MicrochipTech/veryVerilog/doc/USB_Bridge.pdf

## USB bridge

Developer’s guide

## Main functions

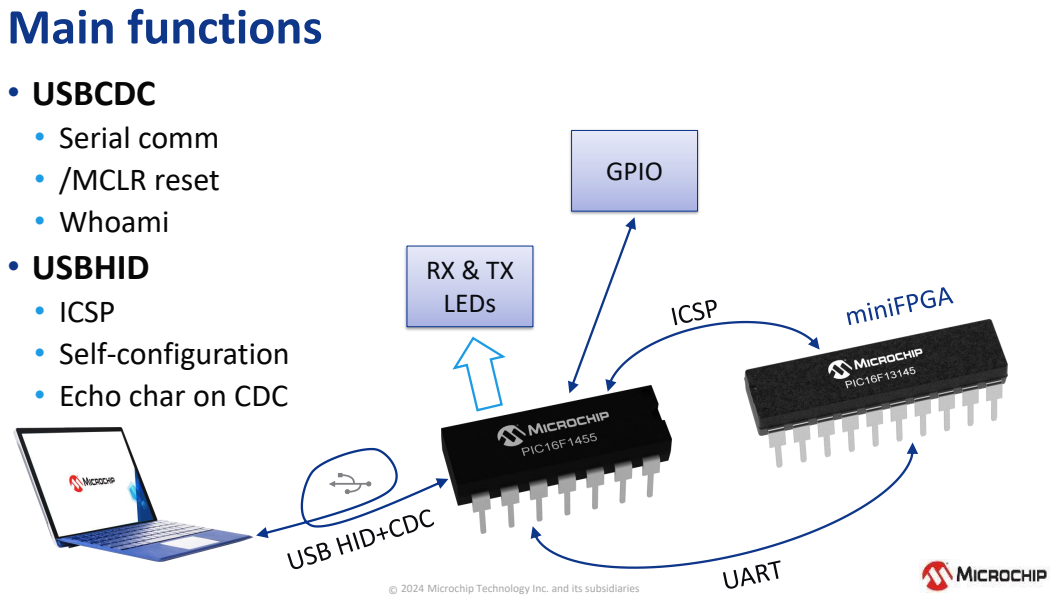
[picture p10: page 2]
17 December 2024 ©; Microchip Technology Inc. and its subsidiaries; RX & TX LEDs; GPIO

• USBCDC
• Serial comm
• /MCLR reset
• Whoami
• USBHID
• ICSP
• Self-configuration
• Echo char on CDC

## Pinout

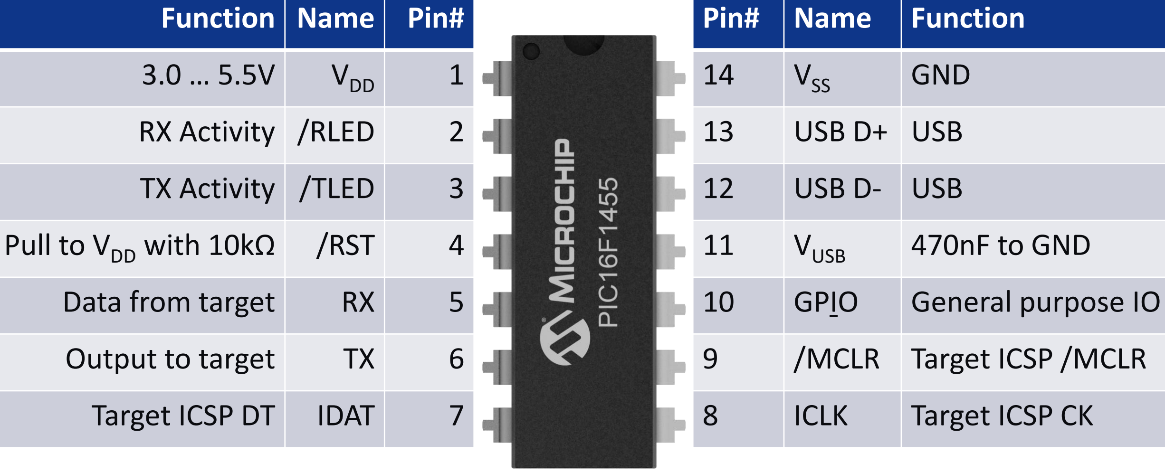
[picture p11: figure]
Pin#; Name; Function; VSS; GND; USB D+; USB; USB D-; VUSB; 470nF to GND; GPIO; General purpose IO; /MCLR; Target ICSP /MCLR; ICLK; Target ICSP CK; VDD; RX Activity; /RLED; TX Activity; /TLED; Pull to VDD with 10kΩ; /RST; Data from target; Output to target; Target ICSP DT; IDAT

## Logical structure

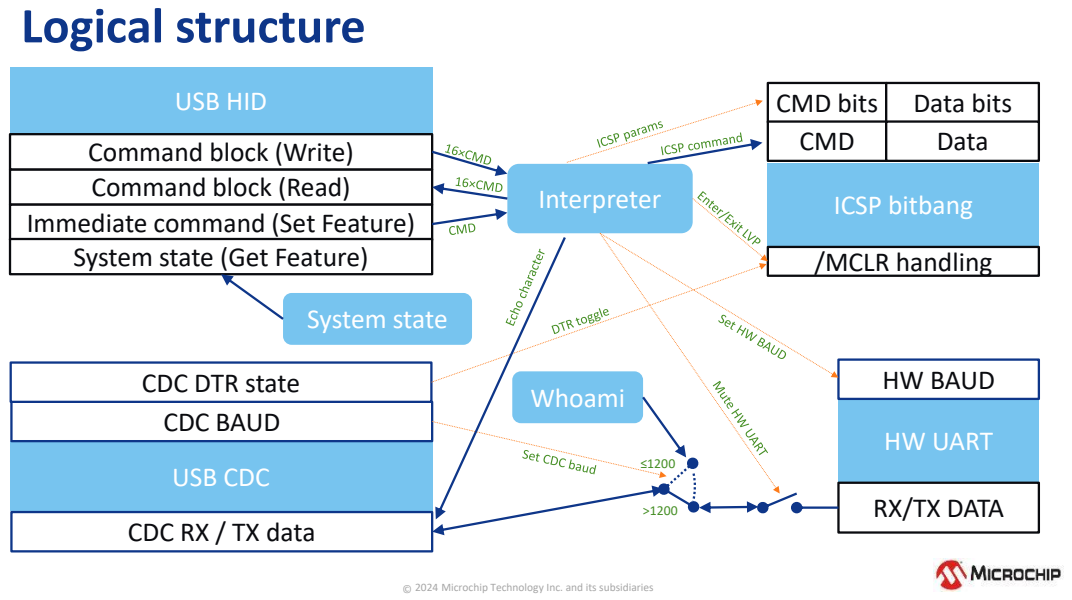
[picture p12: page 4]
HW UART; ICSP bitbang; USB HID; USB CDC; HW BAUD; /MCLR handling; CDC BAUD; CDC DTR state; Whoami; System state

CMD bits | Data bits
CMD | Data

Command block (Write)
Interpreter Command block (Read)
Immediate command (Set Feature)
System state (Get Feature)

RX/TX DATA

CDC RX / TX data

## USB CDC (virtual serial port) interface

- Setting the DTR active will keep target in RESET
- Clearing the DTR will cycle target RESET pin and release RESET
- Setting baud rate ≤1200
- Mutes HW UART
- Sends “Who am I?” JSON string
- Example {"app":"miniFPGA board","USBFW":“0100","meta_cmd":255}
- Setting baud rate >1200
- Connects HW UART to CDC UART
- Unmutes HW UART
- HW baud rate is not affected! (HWBAUD is set by HID commands!)

## USB HID reports

- VID:PID = 0x04D8:0xE594
- Usage page: 0xFF00 (Vendor Page 1)
- Usage: 0x0001 (Vendor Usage 1)
- Report ID 0
- Read data (64bytes)
- Write data (64bytes)
- Get_feature (8bytes)
- Set_feature (8bytes)

## HID get_feature – RPTID0

- Returns 8 bytes with the following structure
Byte0 | Byte1 | Byte2 | Byte3 | Byte4 | Byte5 | Byte6 | Byte7
MCMD_ID | target_state | HWBaud_L | HWBaud_H | HWBaud_U | PORTA | PORTB | PORTC

MCMD_ID → Metacommand value
target_state → 0 – Running (MCLR_HIGH) 1 – Transitioning from STOP to RUN (MCLR_LOW) 2 – Stopped (MCLR_LOW)

HWBaud → HW UART baud rate = (HWBaud_U << 16) + (HWBaud_H << 8) + HWBaud_L PORTA → PORTA value at the moment of executing get_feature
PORTB → PORTB value at the moment of executing get_feature
PORTC → PORTC value at the moment of executing get_feature

## HID set_feature – RPTID0

- Executes a single metacommand
- Not all meta commands are available via set_feature
- 8byte buffer is interpreted as:
- Command (1byte) + no parameters
- Command (1byte) + unsigned byte parameter (1byte)
- Command (1byte) + unsigned word parameter (2bytes)
Byte0 | Byte1 | Byte2 | Byte3 | Byte4 | Byte5 | Byte6 | Byte7
MCMD_ID | × Don’t care | × Don’t care | × Don’t care | × Don’t care | × Don’t care | × Don’t care | × Don’t care
Byte0 | Byte1 | Byte2 | Byte3 | Byte4 | Byte5 | Byte6 | Byte7
MCMD_ID | Parameter8 | × Don’t care | × Don’t care | × Don’t care | × Don’t care | × Don’t care | × Don’t care
Byte0 | Byte1 | Byte2 | Byte3 | Byte4 | Byte5 | Byte6 | Byte7
MCMD_ID | Parameter16 (L:H) | | × Don’t care | × Don’t care | × Don’t care | × Don’t care | × Don’t care

## HID set_feature – RPTID0

ICSP_MCMD_SET_HWUART_BAUD = 1
- Sets the HW UART new Baud rate
- The 100×Word parameter is set as new Baud rate for HW UART
- Word parameter range is 2…1152
- For 9600 baud the Word parameter = 96, for 115200 → 1152
- Example: 57600baud→57600/100→576→0x240→0x40;0x02
Byte0 | Byte1 | Byte2 | Byte3 | Byte4 | Byte5 | Byte6 | Byte7
0x01 | <new Baud rate / 100> | | × Don’t care | × Don’t care | × Don’t care | × Don’t care | × Don’t care
Byte0 | Byte1 | Byte2 | Byte3 | Byte4 | Byte5 | Byte6 | Byte7
0x01 | 0x40 | 0x02 | × Don’t care | × Don’t care | × Don’t care | × Don’t care | × Don’t care

## HID set_feature – RPTID0

ICSP_MCMD_SET_METACMD = 2
- Sets the new metacommand value
- The byte parameter is set as new CMD_ID_MCMD
- Example: Set metacommand CMD_ID to 186 → 0xBA
Byte0 | Byte1 | Byte2 | Byte3 | Byte4 | Byte5 | Byte6 | Byte7
0x02 | <new CMD_ID_MCMD> | × Don’t care | × Don’t care | × Don’t care | × Don’t care | × Don’t care | × Don’t care
Byte0 | Byte1 | Byte2 | Byte3 | Byte4 | Byte5 | Byte6 | Byte7
0x02 | 0xBA | × Don’t care | × Don’t care | × Don’t care | × Don’t care | × Don’t care | × Don’t care

## HID set_feature – RPTID0

ICSP_MCMD_HWUART_ENABLE = 10
- Enables / disables HW UART bridging to USB CDC
- Non-zero byte parameter enables bridging
- Example: Disable HWUART to CDC Bridging: Enable=0 → 0x00
- Example: Enable HWUART to CDC Bridging: Enable=1 → 0x01
Byte0 | Byte1 | Byte2 | Byte3 | Byte4 | Byte5 | Byte6 | Byte7
0x0A | <Enable bridging> | × Don’t care | × Don’t care | × Don’t care | × Don’t care | × Don’t care | × Don’t care
Byte0 | Byte1 | Byte2 | Byte3 | Byte4 | Byte5 | Byte6 | Byte7
0x0A | 0x00 | × Don’t care | × Don’t care | × Don’t care | × Don’t care | × Don’t care | × Don’t care
Byte0 | Byte1 | Byte2 | Byte3 | Byte4 | Byte5 | Byte6 | Byte7
0x0A | 0x01 | × Don’t care | × Don’t care | × Don’t care | × Don’t care | × Don’t care | × Don’t care

## HID set_feature – RPTID0

ICSP_MCMD_USBCDC_SEND = 11
- Send ASCII character to USB CDC. HW UART is not affected
- Byte parameter is the ASCII value to send to CDC UART
- Used to check if serial port open is connected to this HID device
- Example: Send ‘U’ to USBCDC ‘U’→0x55
Byte0 | Byte1 | Byte2 | Byte3 | Byte4 | Byte5 | Byte6 | Byte7
0x0B | <ASCII Character> | × Don’t care | × Don’t care | × Don’t care | × Don’t care | × Don’t care | × Don’t care
Byte0 | Byte1 | Byte2 | Byte3 | Byte4 | Byte5 | Byte6 | Byte7
0x0B | 0x55 | × Don’t care | × Don’t care | × Don’t care | × Don’t care | × Don’t care | × Don’t care

## HID OUT (write) commands

- USB HID interface is used to send ICSP commands to target
- All commands are 4 bytes in length
- Each command is passed through an internal interpreter
- HID Write always sends 16 commands, 4bytes each
- If less than 16 commands are used, fill rest with “MCMD_NOP”

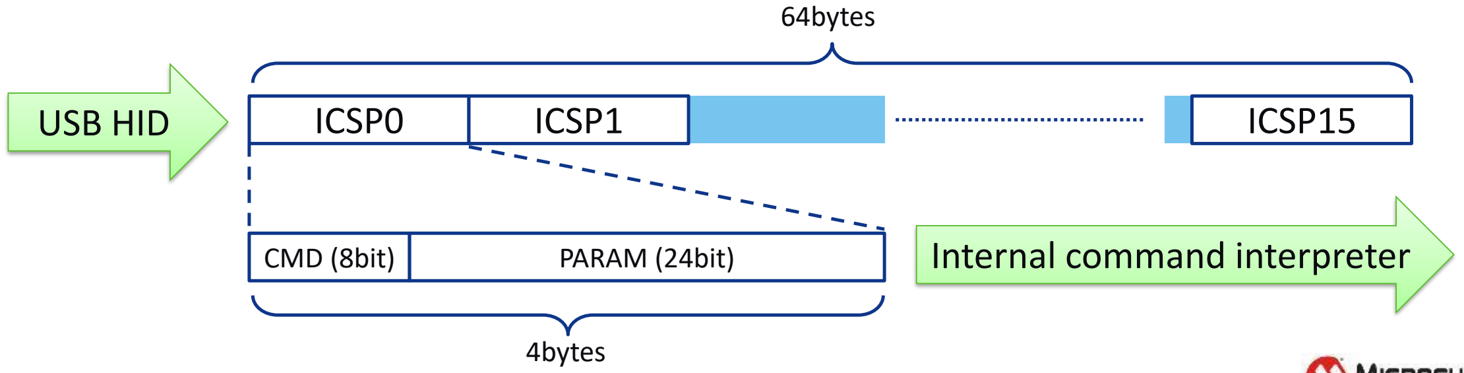
[picture p13: figure]
ICSP0; ICSP1; ICSP15; CMD (8bit); PARAM (24bit); 64bytes; 4bytes; USB HID; Internal command interpreter

## HID OUT (write) ICSP commands

- An ICSP command consist of a CMD and optionally a Payload
- The CMD & Payload values are in the PIC Programming Specs DS
- {#CMD bits} and {#Data bits} are adjustable (described later)
- The USB bridge will shift out total {#CMD bits} + {#Data bits} bits
- No Payload expected? Set {#Data bits} to 0!

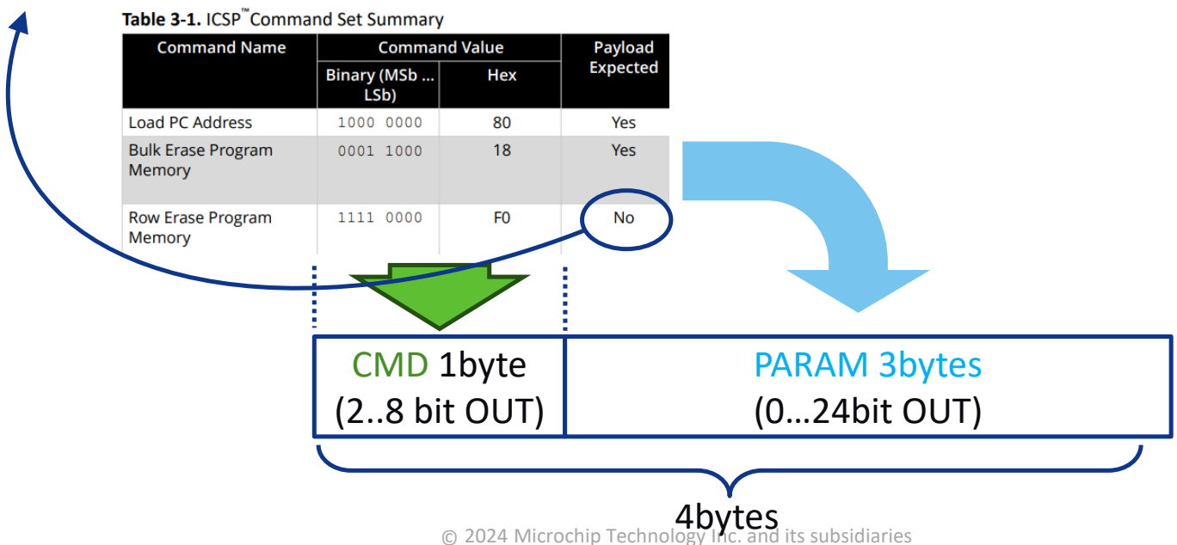
[picture p14: figure]
CMD 1byte (2..8 bit OUT); PARAM 3bytes (0…24bit OUT); 4bytes

## HID ICSP metacommands

- Metacommands not part of the ICSP protocol
- Metacommand if CMD_ID == CMD_ID_MCMD (default 0xFF)
- Usually for setting parameters and control the interpreter
- Example metacommands:
- Enter / exit LVP mode / reset target
- Change HW baud
- Delay X microsec
- Read data
- Echo char from HID to CDC
- Read data from target
- etc.
- Only transmitting data to the target if specifically noted in doc.

## HID ICSP metacommand format

- Only Interpreter decides if command is transmitted over ICSP or treated as metacommand
- All commands where CMD_ID ≠ CMD_ID_MCMD are transmitted to ICLK/IDAT pins
- Metacommand has 0 or 1 parameter (8/16bit)
Byte0 | Byte1 | Byte2 | Byte3
CMD_ID (8bit) | PARAM (24bit)
CMD_ID_MCMD | MCMD_ID | × Don’t care
CMD_ID_MCMD | MCMD_ID | Parameter8 | × Don’t care
CMD_ID_MCMD | MCMD_ID | Parameter16 (L:H)

ICSP CMD
Metacmd
Metacmd
Metacmd

## HID IN (read) commands

- After execution of a command block, a HID response is sent
- All command responses are 4 bytes in length
- HID Reply always sends 16 responses, 4bytes each
- Most of the responses are equal to the command byte sequence

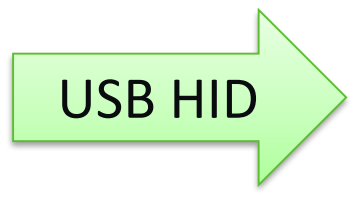
[picture p15: figure]
USB HID

RESP0 | RESP1 | RESP15

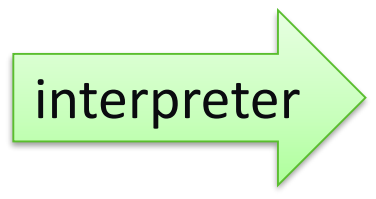
[picture p16: figure]
interpreter

Interpreter response (32bit)

64bytes

4bytes

## HID metacommand

ICSP_MCMD_NOP = 0
- No operation. Used for filling the HID buffer
- Example: No operation (CMD_ID_MCMD = 0xFF)
Byte0 | Byte1 | Byte2 | Byte3
CMD_ID_MCMD | 0x00 | × Don’t care
Reply → | CMD_ID_MCMD | 0x00 | × Don’t care < same as CMD Byte2 and Byte3 >
Byte0 | Byte1 | Byte2 | Byte3
0xFF | 0x00 | 0x00 | 0x00
Reply → | 0xFF | 0x00 | 0x00 | 0x00

CMD →

CMD →

## HID metacommand

ICSP_MCMD_SET_HWUART_BAUD = 1
- Sets the HW UART new Baud rate
- The 100×Word parameter is set as new Baud rate for HW UART
- Word parameter range is 2…1152
- For 9600 baud the Word parameter = 96, for 115200 → 1152
- Exact baud baud rate set can be read with HID get_feature
- Example: 57600baud→57600/100→576→0x240→0x40;0x02
Byte0 | Byte1 | Byte2 | Byte3
CMD_ID_MCMD | 0x01 | <new Baud rate / 100>
Reply → | CMD_ID_MCMD | 0x01 | <Requested Baud rate / 100 >
Byte0 | Byte1 | Byte2 | Byte3
0xFF | 0x01 | 0x40 | 0x02
Reply → | 0xFF | 0x01 | 0x40 | 0x02

CMD →

CMD →

## HID metacommand

ICSP_MCMD_SET_METACMD = 2
- Sets the new CMD_ID_MCMD
- CMD_ID_MCMD changes only if new CMD_ID_MCMD ≤255
- Example: Set new CMD_ID_MCMD to 100→0x0064→0x64;0x00
- Example: Set new CMD_ID_MCMD to 999→0x03E7→0xE7;0x03
Byte0 | Byte1 | Byte2 | Byte3
CMD_ID_MCMD | 0x02 | <new CMD_ID_MCMD>
Reply → | Previous CMD_ID_MCMD | 0x02 | <CMD_ID_MCMD in effect after this command completed>
Byte0 | Byte1 | Byte2 | Byte3
0xFF | 0x02 | 0x64 | 0x00
Reply → | 0xFF | 0x02 | 0x64 | 0x00

CMD →

CMD →

Byte0 | Byte1 | Byte2 | Byte3
0x64 | 0x02 | 0xE7 | 0x03
Reply → | 0x64 | 0x02 | 0x64 | 0x00

CMD →

## HID metacommand

ICSP_MCMD_SET_CMD_BITS = 3
- Sets # of bits transmitted to target from the ICSP 8bit CMD_ID
- 1 < {#CMD bits} ≤ 8 (Default: =8)
- Example: Set new {#CMD bits} to 6→0x0006→0x06;0x00
- Example: Set new {#CMD bits} to 9999→0x270F→0x0F;0x27
Byte0 | Byte1 | Byte2 | Byte3
CMD_ID_MCMD | 0x03 | <new {#CMD bits} >
Reply → | CMD_ID_MCMD | 0x03 | <{#CMD bits} in effect after this command completed>
Byte0 | Byte1 | Byte2 | Byte3
0xFF | 0x03 | 0x06 | 0x00
Reply → | 0xFF | 0x03 | 0x06 | 0x00

CMD →

CMD →

Byte0 | Byte1 | Byte2 | Byte3
0xFF | 0x03 | 0x0F | 0x27
Reply → | 0xFF | 0x03 | 0x06 | 0x00

CMD →

## HID metacommand

ICSP_MCMD_SET_DATA_BITS = 4
- Sets # of bits transmitted to target from the ICSP 24bit PARAM
- 0 ≤ {#Data bits} ≤ 24 (Default: =24)
- Example: Set new {#Data bits} to 16→0x0010→0x10;0x00
- Example: Set new {#Data bits} to 55→0x0037→0x37;0x00
Byte0 | Byte1 | Byte2 | Byte3
CMD_ID_MCMD | 0x04 | <new {#Data bits} >
Reply → | CMD_ID_MCMD | 0x04 | <{#Data bits} in effect after this command completed>
Byte0 | Byte1 | Byte2 | Byte3
0xFF | 0x04 | 0x10 | 0x00
Reply → | 0xFF | 0x04 | 0x10 | 0x00

CMD →

CMD →

Byte0 | Byte1 | Byte2 | Byte3
0xFF | 0x04 | 0x37 | 0x00
Reply → | 0xFF | 0x04 | 0x10 | 0x00

CMD →

## HID metacommand with pin state changes

ICSP_MCMD_LVP_ENTER = 5
- Enter low voltage programming mode if possible (takes ≈25ms)
- LVP can be disabled in CONFIG bits ( )
- Factory shipped (blank) devices has LVP enabled
- It is not verified if the target is successfully in LVP
- The command will keep target MCLR pin low, ICLK→OutputL ( )
- Example: Enter LVP with default (MSB first) method
Byte0 | Byte1 | Byte2 | Byte3
CMD_ID_MCMD | 0x05 | × Don’t care
Reply → | CMD_ID_MCMD | 0x05 | × Don’t care < same as CMD Byte2 and Byte3 >
Byte0 | Byte1 | Byte2 | Byte3
0xFF | 0x05 | 0x00 | 0x00
Reply → | 0xFF | 0x05 | 0x00 | 0x00

CMD →

CMD →

## HID metacommand with pin state changes

ICSP_MCMD_LVP_ENTER = 5
- In FW v1.2 alternative method for enter LVP is defined
- Method 1 = 0xFE01
- Valid for devices where LSb must be shifted in first to enter LVP
- Shift direction change affects only the enter LVP key sequence
- Example: Enter LVP with LSB first method→0xFE01→0x01;0xFE
Byte0 | Byte1 | Byte2 | Byte3
CMD_ID_MCMD | 0x05 | Method ID
Reply → | CMD_ID_MCMD | 0x05 | Method ID
Byte0 | Byte1 | Byte2 | Byte3
0xFF | 0x05 | 0x01 | 0xFE
Reply → | 0xFF | 0x05 | 0x01 | 0xFE

CMD →

CMD →

V1.2

## HID metacommand with pin state changes

ICSP_MCMD_LVP_EXIT = 6
- Set ICLK→Input, IDAT→INPUT, release target MCLR
- Example: Release target MCLR → run the code
Byte0 | Byte1 | Byte2 | Byte3
CMD_ID_MCMD | 0x06 | × Don’t care
Reply → | CMD_ID_MCMD | 0x06 | × Don’t care < same as CMD Byte2 and Byte3 >
Byte0 | Byte1 | Byte2 | Byte3
0xFF | 0x06 | 0x00 | 0x00
Reply → | 0xFF | 0x06 | 0x00 | 0x00

CMD →

CMD →

## HID metacommand

ICSP_MCMD_DELAY_us = 7
- Immediate delay for <parameter16> µsec
- Delays in a loop⇒<parameter16>×(1µsec + loop instruction exec)
- Maximum delay ≈65.5msec
- Example: Delay ≈1ms→1000→0x03E8→0xE8;0x03
Byte0 | Byte1 | Byte2 | Byte3
CMD_ID_MCMD | 0x07 | Delay length in µsec
Reply → | CMD_ID_MCMD | 0x07 | Delay length in µsec
Byte0 | Byte1 | Byte2 | Byte3
0xFF | 0x07 | 0xE8 | 0x03
Reply → | 0xFF | 0x07 | 0xE8 | 0x03

CMD →

CMD →

## HID metacommand with pin state changes

ICSP_MCMD_READ_CMD = 8
- Sends RD_CMD_ID ICSP command and reads data response
- Parameter RD_CMD_ID sent according to {#CMD bits}
- Replies zero padded {#Data bits} from device
- Example: Read empty FLASH word from PIC16F13145
Read Data from NVM→ RD_CMD_ID=0xFC Empty FLASH=0x003FFF
Byte0 | Byte1 | Byte2 | Byte3
CMD_ID_MCMD | 0x08 | ICSP Read RD_CMD_ID | × Don’t care
Reply → | RD_CMD_ID | DATA_L | DATA_H | DATA_U
Byte0 | Byte1 | Byte2 | Byte3
0xFF | 0x08 | 0xFC | 0x00
Reply → | 0xFC | 0xFF | 0x3F | 0x00

CMD →

CMD →

0x003FFF

## HID metacommand

ICSP_MCMD_GET_HWUART_BAUD = 9
- Get exact HW UART baud rate
- Example: HW UART baud?→Exact baud=115213→0x01C20D
Byte0 | Byte1 | Byte2 | Byte3
CMD_ID_MCMD | 0x00 | × Don’t care
Reply → | CMD_ID_MCMD | Exact baud rate <24bits>
Byte0 | Byte1 | Byte2 | Byte3
0xFF | 0x09 | 0x00 | 0x00
Reply → | 0xFF | 0x0D | 0xC2 | 0x01

CMD →

CMD →

## HID metacommand

ICSP_MCMD_HWUART_ENABLE = 10
- Enables or disables HWUART CDC bridging
- Useful for avoiding random characters during programming
- Example: Enable HWUART CDC bridging →0x0001→0x01;0x00
- Example: Disable HWUART CDC bridging →0x0000→0x00;0x00
Byte0 | Byte1 | Byte2 | Byte3
CMD_ID_MCMD | 0x0A | <Non-zero to enable HWUART to CDC bridging>
Reply → | CMD_ID_MCMD | 0x0A | 0x0000→Bridging disabled 0x0001→Bridging enabled
Byte0 | Byte1 | Byte2 | Byte3
0xFF | 0x0A | 0x01 | 0x00
Reply → | 0xFF | 0x0A | 0x01 | 0x00

CMD →

CMD →

Byte0 | Byte1 | Byte2 | Byte3
0xFF | 0x0A | 0x00 | 0x00
Reply → | 0xFF | 0x0A | 0x00 | 0x00

CMD →

## HID metacommand

ICSP_MCMD_USBCDC_SEND = 11
- Sends ASCII character to USB UART (USBCDC)
- HWUART not affected!
- Reply contains Success/Fail indication
- Used to match HID to USBCDC
- Example: Send ‘U’ to USBCDC → 0x55 → 0x0055 → 0x55;0x00
Byte0 | Byte1 | Byte2 | Byte3
CMD_ID_MCMD | 0x0B | ASCII character value to send via USBCDC | × Don’t care
Reply → | CMD_ID_MCMD | 0x0B | ASCII character value | 0x00→queue full 0x01→ASCII char queued
Byte0 | Byte1 | Byte2 | Byte3
0xFF | 0x0B | 0x55 | 0x00
Reply → | 0xFF | 0x0B | 0x55 | 0x01

CMD →

CMD →

## HID metacommand with pin state changes

ICSP_MCMD_GPIO = 12
- Controls IO pins (0=Out, 1=Input, 0=Low, 1=High)
- 1

st set direction, 2nd write outputs, 3rd read inputs
- Reply contains digital value on the PIN (0=Low, 1=High)
- Used to blink RX/TX LEDs, add virtual buttons & LEDs
- Setting Pin5 or Pin6 to output, disables HW UART!
- Example: TXLED=off, RXLED=on, other pins=input → 0xFC;0x02
Byte0 | Byte1 | Byte2 | Byte3
CMD_ID_MCMD | 0x0B | Pin I/O Direction values | Set OUTPUT pins H/L values
Reply → | CMD_ID_MCMD | 0x0B | Pin logic levels bit values | OUTPUT pin bit values, × for input bits
Byte0 | Byte1 | Byte2 | Byte3
0xFF | 0x0B | 0xFC | 0x02
Reply → | 0xFF | 0x0B | 0xFE | 0x02

CMD →

CMD →

IC Pin # | Bit
2-/RLED | 0 (IO)
3-/TLED | 1 (IO)
5-RX | 2 (IO )
6-TX | 3 (IO )
7-IDAT | 4 (IO)
8-ICLK | 5 (IO)
9-/MCLR | 6 (IO)
10-GPIO | 7 (IO)

V1.2

## HID metacommand

ICSP_MCMD_DELAY_ms = 13
- Immediate delay for <parameter16> msec
- Maximum delay ≈1h5min
- Delay will be interrupted on reception of new HID Write packet
- On interrupt ,no reply, new packet will be processed from ICSP0
- Example: Delay ≈100ms→100→0x0064→0x64;0x00
Byte0 | Byte1 | Byte2 | Byte3
CMD_ID_MCMD | 0x0D | Delay length in msec
Reply → | CMD_ID_MCMD | 0x0D | Delay length in msec
Byte0 | Byte1 | Byte2 | Byte3
0xFF | 0x0D | 0x64 | 0x03
Reply → | 0xFF | 0x0D | 0x64 | 0x03

CMD →

CMD →

V1.2

## ICSP REVID&DEVID read sequence example

PIC16F13145

byte0 | byte1 | byte2 | byte3 | Comment
0xFF | 0x06 | 0x00 | 0x00 | ICSP_MCMD_LVP_EXIT = 6 → LVP Exit (Make sure, chip is able to go in LVP)
0xFF | 0x03 | 0x08 | 0x00 | ICSP_MCMD_SET_CMD_BITS = 3 → Set ICSP {#CMD bits} to 8 (Pgspec P12 - 3.2 Program/Verify Commands)
0xFF | 0x04 | 0x18 | 0x00 | ICSP_MCMD_SET_DATA_BITS = 4 → Set ICSP {#Data bits} to 24 (Pgspec P12 - 3.2 Program/Verify Commands)
0xFF | 0x05 | 0x00 | 0x00 | ICSP_MCMD_LVP_ENTER = 5 → LVP Enter with MSB first method (Pgspec P11 – 3.1.2 Low-Voltage Programming (LVP) Mode)
0x80 | 0x0A | 0x00 | 0x01 | HID OUT (write) ICSP commands → Set program counter to REVID location(0x8005<<1) (Pgspec P14 - 3.2.1 Load PC Address)
0xFF | 0x08 | 0xFE | 0x00 | ICSP_MCMD_READ_CMD = 8 → Read location at PC with PC increment → REVID (Pgspec P16 - 3.2.5 Read Data from NVM )
0xFF | 0x08 | 0xFC | 0x00 | ICSP_MCMD_READ_CMD = 8 → Read location at PC → DEVID (Pgspec P16 - 3.2.5 Read Data from NVM )
0xFF | 0x06 | 0x00 | 0x00 | ICSP_MCMD_LVP_EXIT = 6 → LVP Exit
0xFF | 0x00 | 0x00 | 0x00 | ICSP_MCMD_NOP = 0 → NOP
0xFF | 0x00 | 0x00 | 0x00 | ICSP_MCMD_NOP = 0 → NOP |
︙ | ︙ | ︙ | ︙ | ︙
︙ | ︙ | ︙ | ︙ | ︙
0xFF | 0x00 | 0x00 | 0x00 | Sixteenth instruction : ICSP_MCMD_NOP = 0 → NOP
byte0 | byte1 | Comment
0x02 | 0xFF | HID set_feature – RPTID0: ICSP_MCMD_SET_METACMD = 2 → No 0xFF ICSP cmd, set CMD_ID_MCMD to 0xFF (Pgspec P13, Table 3-1 . ICSP Command Set)

Programming Specs: DS40002500B (https://ww1.microchip.com/downloads/aemDocuments/documents/MCU08/ProductDocuments/ProgrammingSpecifications/PIC16F13145-Family-Programming-Specification-DS400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)

JS: sendFeatureReport() Win: HidD_SetFeature() PY hidapi: send_feature_report()

JS: write() Win: write() PY hidapi: write()

## ICSP REVID&DEVID read sequence example

PIC16F1455

byte0 | byte1 | byte2 | byte3 | Comment
0xFF | 0x06 | 0x00 | 0x00 | ICSP_MCMD_LVP_EXIT = 6 → LVP Exit (Make sure, chip is able to go in LVP)
0xFF | 0x03 | 0x06 | 0x00 | ICSP_MCMD_SET_CMD_BITS = 3 → Set ICSP {#CMD bits} to 6 (Pgspec P14 - 4.3 Program/Verify Commands)
0xFF | 0x04 | 0x10 | 0x00 | ICSP_MCMD_SET_DATA_BITS = 4 → Set ICSP {#Data bits} to 16 (Pgspec P14 – 4.3 Program/Verify Commands)
0xFF | 0x05 | 0x01 | 0xFE | ICSP_MCMD_LVP_ENTER = 5 → LVP Enter with LSB first method (Pgspec: P13 – 4.2 Low-Voltage Programming (LVP) Mode)
0x00 | 0x00 | 0x00 | 0x00 | HID OUT (write) ICSP commands → Set program counter to CONFIG location (0x8000) (Pgspec P14 - 4.3.1 Load Configuration)
0xFF | 0x04 | 0x18 | 0x00 | ICSP_MCMD_SET_DATA_BITS = 4 → Set ICSP {#Data bits} to 24 → CMD6+4*CMD6bit as parameter = 5×CMD6
0x06 | 0x18 | 0x86 | 0x61 | HID OUT (write) ICSP commands → send 5×{6bit command} 0x06 → 5× Increment pointer → PC=0x8005
0xFF | 0x04 | 0x10 | 0x00 | ICSP_MCMD_SET_DATA_BITS = 4 → Set ICSP {#Data bits} to 16 (Pgspec P14 – 4.3 Program/Verify Commands)
0xFF | 0x08 | 0x04 | 0x00 | ICSP_MCMD_READ_CMD = 8 → Read location at PC → REVID (Pgspec P15 - 3.2.5 Read Data from NVM )
0xFF | 0x04 | 0x00 | 0x00 | ICSP_MCMD_SET_DATA_BITS = 4 → Set ICSP {#Data bits} to 0, Increment address command has no data (Pgspec P14 – 4.3 Program/Verify Commands)
0x06 | 0x00 | 0x00 | 0x00 | HID OUT (write) ICSP commands → Increment PC Address → PC=0x8006 (Pgspec P15 – 4.3.4 Increment Address)
0xFF | 0x04 | 0x10 | 0x00 | ICSP_MCMD_SET_DATA_BITS = 4 → Set ICSP {#Data bits} to 16 (Pgspec P14 – 4.3 Program/Verify Commands)
0xFF | 0x08 | 0x04 | 0x00 | ICSP_MCMD_READ_CMD = 8 → Read location at PC → DEVID (Pgspec P15 - 3.2.5 Read Data from NVM )
0xFF | 0x06 | 0x00 | 0x00 | ICSP_MCMD_LVP_EXIT = 6 → LVP Exit (Make sure, chip is able to go in LVP)
0xFF | 0x00 | 0x00 | 0x00 | ICSP_MCMD_NOP = 0 → NOP
0xFF | 0x00 | 0x00 | 0x00 | ICSP_MCMD_NOP = 0 → NOP
byte0 | byte1 | Comment
0x02 | 0xFF | HID set_feature – RPTID0: ICSP_MCMD_SET_METACMD = 2 → No 0xFF ICSP cmd, set CMD_ID_MCMD to 0xFF (Pgspec P13, Table 4-1 . Command Mapping)

Programming Specs: DS41620C (https://ww1.microchip.com/downloads/en/DeviceDoc/41620C.pdf)

JS: sendFeatureReport() Win: HidD_SetFeature() PY hidapi: send_feature_report()

JS: write() Win: write() PY hidapi: write()

V1.2
