MicrochipTech/veryVerilog/image.png

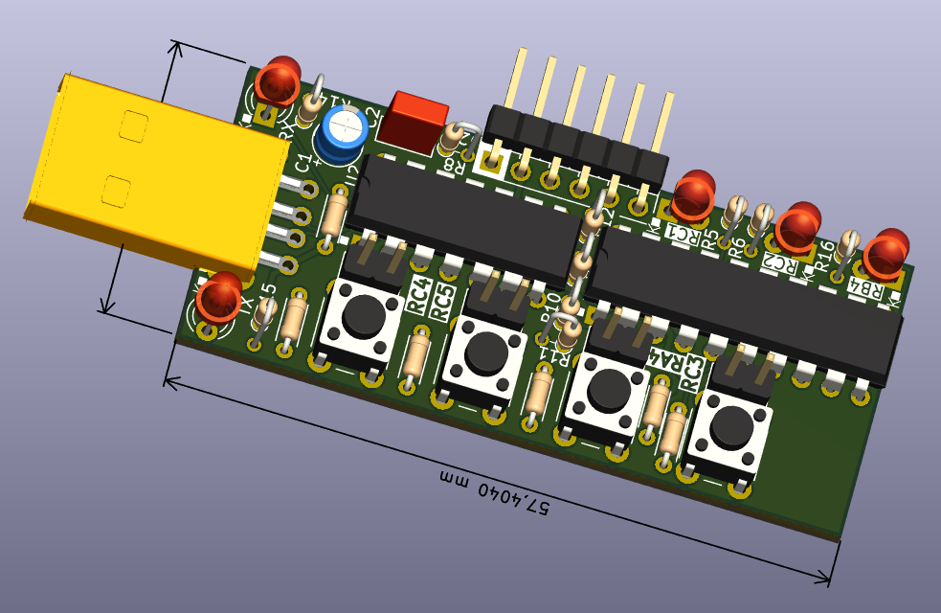
image.png
