MicrochipTech/veryVerilog/PCB/miniFPGA/assembly_steps.xlsx

'Reference' | 'Value' | 'Footprint' | 'Qty' | 'DNP'
'C1' | '4µ7F' | 'Capacitor_THT:CP_Radial_D4.0mm_P2.00mm' | '1' | ''
'C2' | '470nF' | 'Capacitor_THT:C_Rect_L4.6mm_W2.0mm_P2.50mm_MKS02_FKP02' | '1' | ''
'J1' | 'USB_B' | 'Connector_USB:USB_A_CNCTech_1001-011-01101_Horizontal' | '1' | ''
'J2' | 'ICSP_FPGA' | 'Connector_PinHeader_2.54mm:PinHeader_1x06_P2.54mm_Horizontal' | '1' | ''
'JP1,PB1' | 'RC4' | '-- mixed values --' | '2' | ''
'JP2,PB2' | 'RC5' | '-- mixed values --' | '2' | ''
'JP3,PB3' | 'RA4' | '-- mixed values --' | '2' | ''
'JP4,PB4' | 'RC3' | '-- mixed values --' | '2' | ''
'LED1' | 'RX' | 'LED_THT:LED_D3.0mm' | '1' | ''
'LED2' | 'TX' | 'LED_THT:LED_D3.0mm' | '1' | ''
'LED3' | 'RC1' | 'LED_THT:LED_D3.0mm' | '1' | ''
'LED4' | 'RC2' | 'LED_THT:LED_D3.0mm' | '1' | ''
'R1,R2,R3,R4,R7,R13' | '10kΩ' | 'Resistor_THT:R_Axial_DIN0204_L3.6mm_D1.6mm_P5.08mm_Horizontal' | '6' | ''
'R5,R6,R8,R9,R10,R11,R12,R14,R15' | '680Ω' | 'Attila:R_Axial_L3.6mm_D1.6mm_P1.90mm_Vertical' | '9' | ''
'U1' | 'PIC16F13125-IP' | 'Package_DIP:DIP-14_W7.62mm' | '1' | ''
'U2' | 'MCP2221A-IP' | 'Package_DIP:DIP-14_W7.62mm' | '1' | ''
