MicrochipTech/veryVerilog/PCB/miniFPGA/pcb_assembly.txt

J1			
R5,R11,R18
C2
LED1,LED2,LED3,LED4
R1,R2,R3,R4,R6,R7,R8,R9,R10,R12,R13,R14,R15,R16,R17,R19,R20,R21
JP1,JP2,JP3,JP4
PB1,PB2,PB3,PB4
C1			
U1,U2
