MicrochipTech/veryVerilog/(threads)

Thread 4 (2024-12-18):

PCB image shows v2 PCB

apshu, 2024-12-18:
PCB v3 must be rendered and replace /doc/images/pcb.png

Closed 2024-12-19.

Thread 16 (2024-12-19):

Read board analog values

apshu, 2024-12-19:
Metacommand to read analog values from the board (MC team request)

apshu, 2024-12-19:
Reply should have VREF value measured against VDD to calculate more precisely the measured voltage

Thread 27 (2025-03-29):

Add readme to PCB

apshu, 2025-03-29:
Short description about the PCB in the PCB folder

Closed 2025-04-05.

Thread 37 (2025-07-02):

3D rendering in DOCS

apshu, 2025-07-02:
In the “Clean, rinse and dry” section of the manual, there are two 3D renders on how the board should look like when it’s finished. LED5 is missing on both renders.

Thread 41 (2025-07-03):

DCE / DTE clarification on RX/TX

apshu, 2025-07-03:
Add arrow indication to the schematic to represent the flow of UART information . (RX / TX)
