MicrochipTech/veryVerilog/PCB/miniFPGA/miniFPGA_schematics.pdf

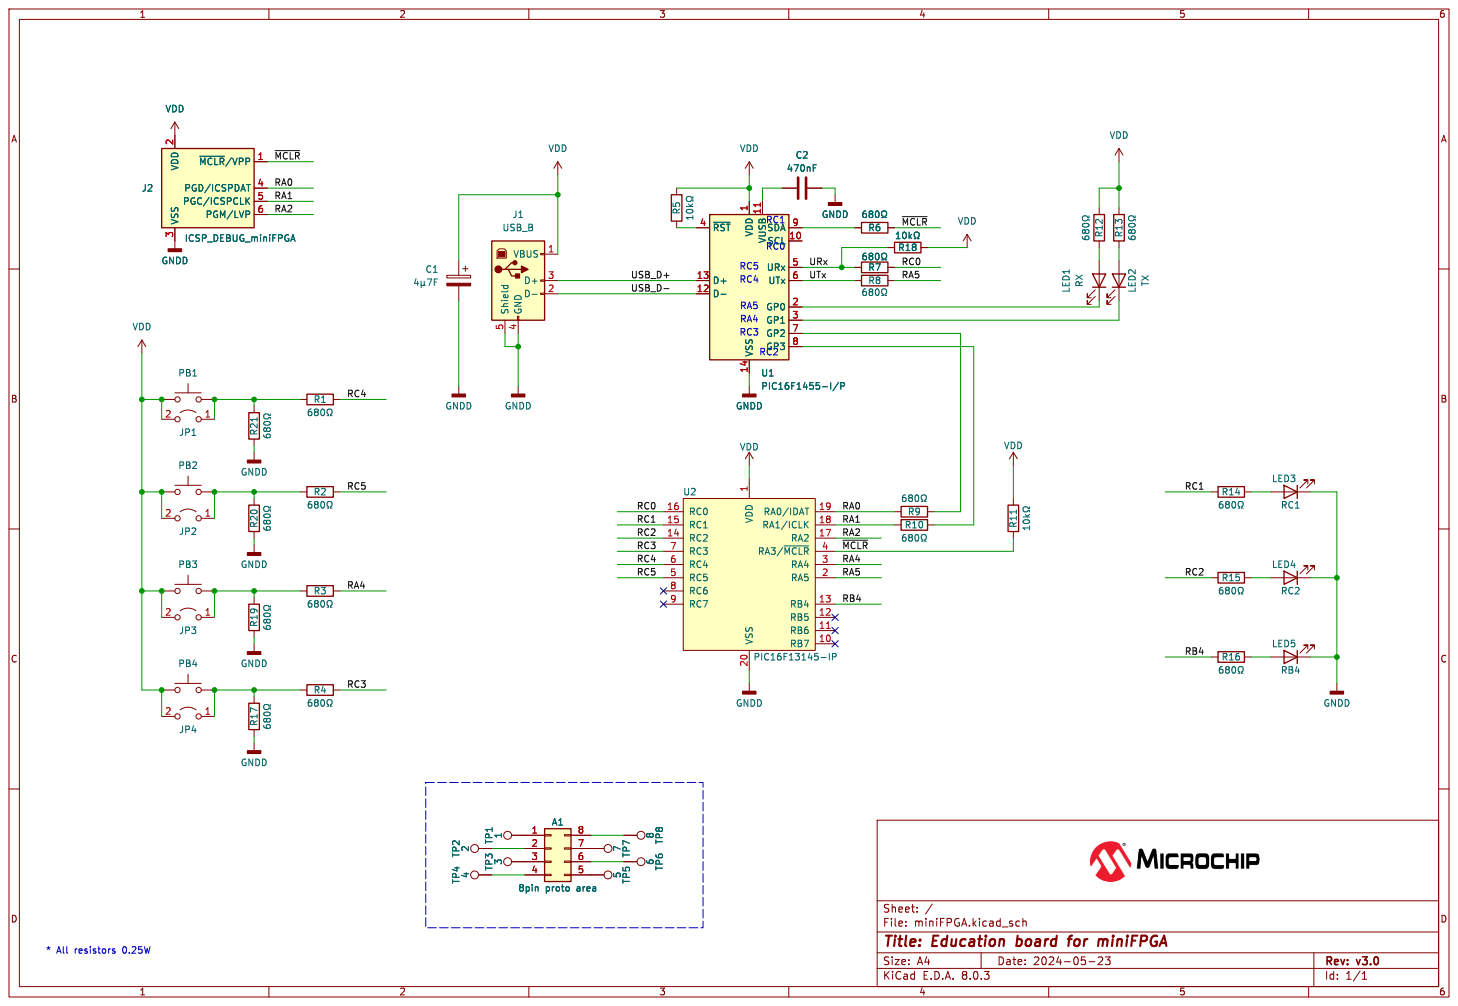
[picture p59: page 1]

3 PGD/ICSPDAT 4 PGC/ICSPCLK 5 PGM/LVP 6 VDD GNDD

VDD LED2 TX R13 þÿ680!& VDD GNDD

3 PGD/ICSPDAT 4 PGC/ICSPCLK 5 PGM/LVP 6

1 SCL 10 VUSB 11 D- 12 D+ 13 VSS 14 GP0 2 GP1 3 ~{RST} 4 URx 5 UTx 6 GP2 7 GP3 8 SDA 9 U1PIC16F1455-I/P GNDD

1 SCL 10 VUSB 11 D- 12 D+ 13 VSS 14 GP0 2 GP1 3 ~{RST} 4 URx 5 UTx 6 GP2 7 GP3 8 SDA 9 GNDD

1 RB7 10 RB6 11 RB5 12 RB4 13 RC2 14 RC1 15 RC0 16 RA2 17 RA1/ICLK 18 RA0/IDAT 19 RA5 2 VSS 20 RA4 3 RA3/~{MCLR} 4 RC5 5 RC4 6 RC3 7 RC6 8 RC7 9 U2 PIC16F13145-IP R3

Id: 1/1 Title: Education board for miniFPGA
