MicrochipTech/veryVerilog/PCB/miniFPGA/miniFPGA.kicad_pcb

## KiCad design PCB/miniFPGA/miniFPGA.kicad_pcb (2025-04-05)

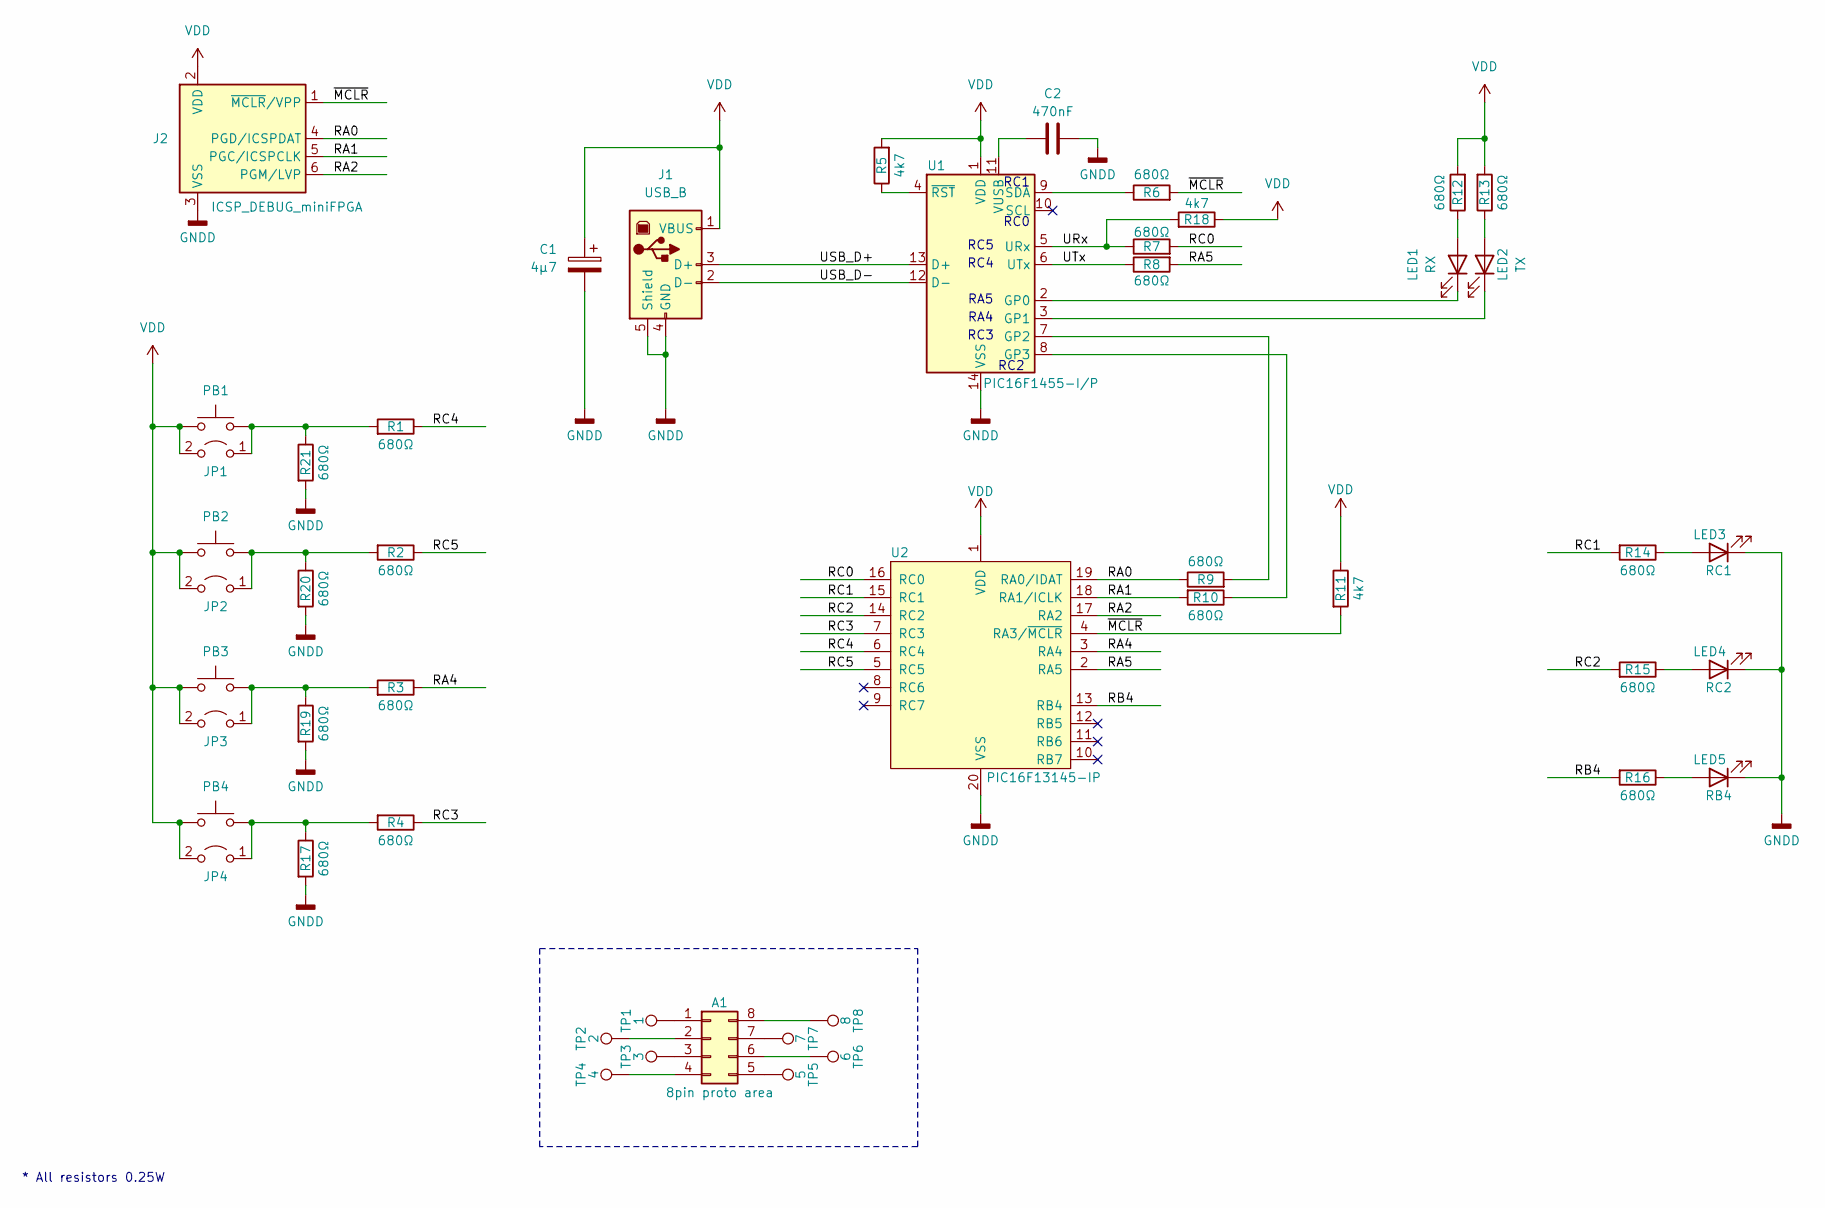
[picture p60: schematic miniFPGA.kicad_sch, Education board for miniFPGA]

Parts:
A1: 8pin proto area; 8pin_proto
C1: 4µ7; CP_Radial_D4.0mm_P2.00mm
C2: 470nF; C_Rect_L4.6mm_W2.0mm_P2.50mm_MKS02_FKP02
J1: USB_B; USB_A_CNCTech_1001-011-01101_Horizontal
J2: ICSP_DEBUG_miniFPGA; PinHeader_1x06_P2.54mm_Horizontal
JP1: RC4; PinHeader_1x02_P2.54mm_Vertical
JP2: RC5; PinHeader_1x02_P2.54mm_Vertical
JP3: RA4; PinHeader_1x02_P2.54mm_Vertical
JP4: RC3; PinHeader_1x02_P2.54mm_Vertical
LED1: RX; LED_D3.0mm
LED2: TX; LED_D3.0mm
LED3: RC1; LED_D3.0mm
LED4: RC2; LED_D3.0mm
LED5: RB4; LED_D3.0mm
PB1: RC4; SW_PUSH_6mm_H5mm
PB2: RC5; SW_PUSH_6mm_H5mm
PB3: RA4; SW_PUSH_6mm_H5mm
PB4: RC3; SW_PUSH_6mm_H5mm
R1, R2, R3, R4, R6, R7, R8, R9, R10, R12, R13, R14, R15, R16, R17, R19, R20, R21: 680Ω; R_Axial_L3.6mm_D1.6mm_P1.90mm_Vertical
R5, R11, R18: 4k7; R_Axial_DIN0204_L3.6mm_D1.6mm_P5.08mm_Horizontal
TP1: 1; TestPoint_Pad_1.5x1.5mm
TP2: 2; TestPoint_Pad_D1.5mm
TP3: 3; TestPoint_Pad_D1.5mm
TP4: 4; TestPoint_Pad_D1.5mm
TP5: 5; TestPoint_Pad_D1.5mm
TP6: 6; TestPoint_Pad_D1.5mm
TP7: 7; TestPoint_Pad_D1.5mm
TP8: 8; TestPoint_Pad_D1.5mm
U1: PIC16F1455-I/P; DIP-14_W7.62mm
U2: PIC16F13145-IP; DIP-20_W7.62mm

Connections:
/RA0: J2.4 (PGD/ICSPDAT), R9.1, U2.19 (RA0/IDAT)
/RA1: J2.5 (PGC/ICSPCLK), R10.2, U2.18 (RA1/ICLK)
/RA2: J2.6 (PGM/LVP), U2.17 (RA2)
/RA4: R3.1, U2.3 (RA4)
/RA5: R8.2, U2.2 (RA5)
/RB4: R16.2, U2.13 (RB4)
/RC0: R7.2, U2.16 (RC0)
/RC1: R14.2, U2.15 (RC1)
/RC2: R15.2, U2.14 (RC2)
/RC3: R4.1, U2.7 (RC3)
/RC4: R1.1, U2.6 (RC4)
/RC5: R2.1, U2.5 (RC5)
/URx: R7.1, R18.2, U1.5 (URx)
/USB_D+: J1.3 (D+), U1.13 (D+)
/USB_D-: J1.2 (D-), U1.12 (D-)
/UTx: R8.1, U1.6 (UTx)
/~MCLR: J2.1 (~MCLR/VPP), R6.2, R11.2, U2.4 (RA3/~MCLR)
GNDD: C1.2, C2.2, J1.4 (GND), J1.5 (Shield), J2.3 (VSS), LED3.1 (K), LED4.1 (K), LED5.1 (K), R17.2, R19.2, R20.2, R21.2, U1.14 (VSS), U2.20 (VSS)
unnamed: A1.1, TP1.1
unnamed: A1.2, TP2.1
unnamed: A1.3, TP3.1
unnamed: A1.4, TP4.1
unnamed: A1.5, TP5.1
unnamed: A1.6, TP6.1
unnamed: A1.7, TP7.1
unnamed: A1.8, TP8.1
unnamed: JP1.1 (A), PB1.1, R1.2, R21.1
unnamed: JP2.1 (A), PB2.1, R2.2, R20.1
unnamed: JP3.1 (A), PB3.1, R3.2, R19.1
unnamed: JP4.1 (A), PB4.1, R4.2, R17.1
unnamed: LED1.2 (A), R12.1
unnamed: LED1.1 (K), U1.2 (GP0)
unnamed: LED2.2 (A), R13.1
unnamed: LED2.1 (K), U1.3 (GP1)
unnamed: LED3.2 (A), R14.1
unnamed: LED4.2 (A), R15.1
unnamed: LED5.2 (A), R16.1
unnamed: R9.2, U1.7 (GP2)
unnamed: R10.1, U1.8 (GP3)
unnamed: R6.1, U1.9 (SDA)
unnamed: C2.1, U1.11 (VUSB)
unnamed: R5.1, U1.4 (~RST)
VDD: C1.1, J1.1 (VBUS), J2.2 (VDD), JP1.2 (B), JP2.2 (B), JP3.2 (B), JP4.2 (B), PB1.2, PB2.2, PB3.2, PB4.2, R5.2, R11.1, R12.2, R13.2, R18.1, U1.1 (VDD), U2.1 (VDD)

Notes on the sheet:
RC3
RC1
RC0
RA5
RC4
RA4
* All resistors 0.25W
RC2
RC5

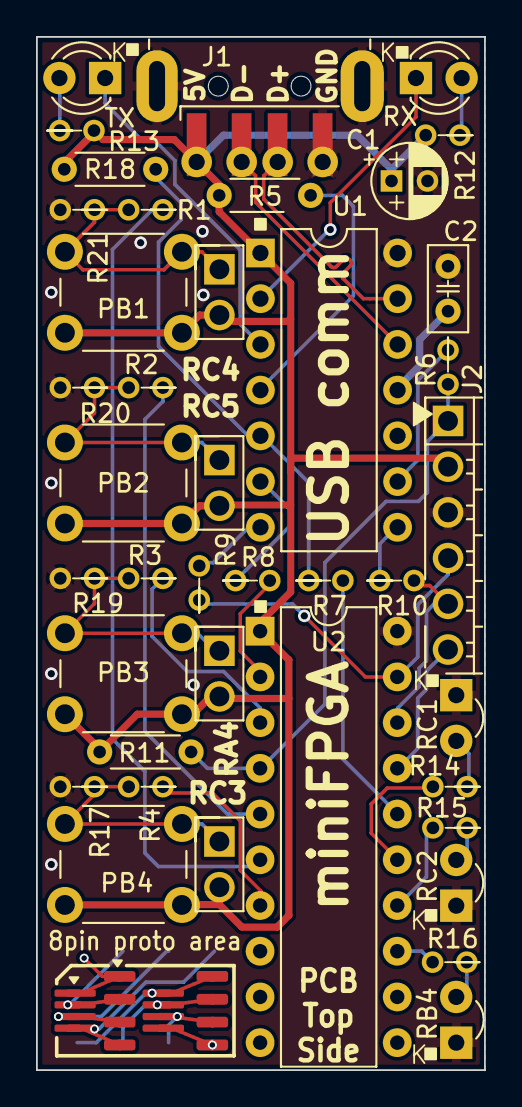
[picture p61: board miniFPGA.kicad_pcb from above]

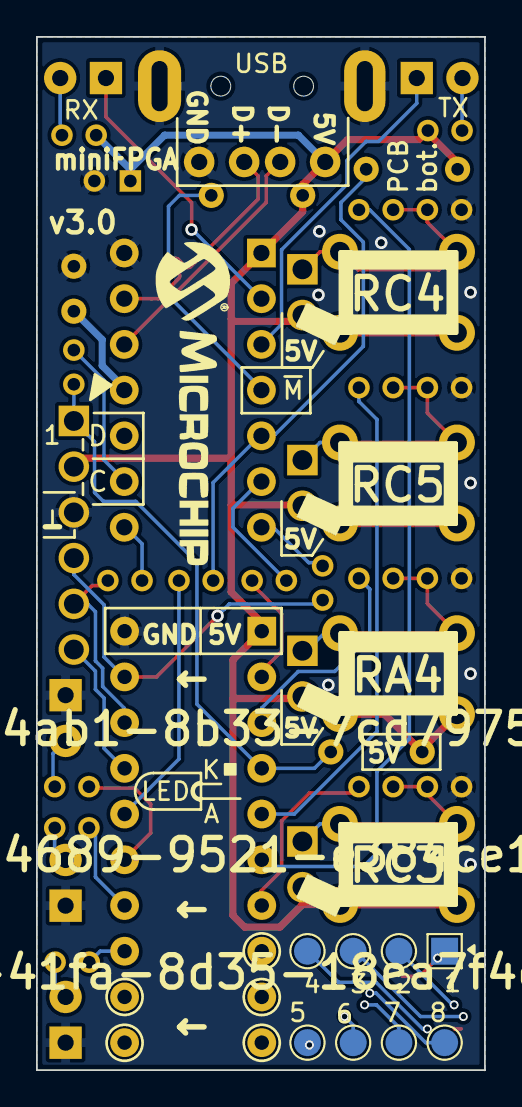
[picture p62: board miniFPGA.kicad_pcb from below]

Board: 2 copper layers, 24.9 x 57.4 mm, 49 parts (8 on the bottom side), 43 nets.
