MicrochipTech/veryVerilog/firmware/U1_USBSerial.X/main.c

/**
  Generated Main Source File

  Company:
    Microchip Technology Inc.

  File Name:
    main.c

  Summary:
    This is the main file generated using PIC10 / PIC12 / PIC16 / PIC18 MCUs

  Description:
    This header file provides implementations for driver APIs for all modules selected in the GUI.
    Generation Information :
        Product Revision  :  PIC10 / PIC12 / PIC16 / PIC18 MCUs - 1.81.6
        Device            :  PIC16F1455
        Driver Version    :  2.00
 */

/*
    (c) 2018 Microchip Technology Inc. and its subsidiaries. 
    
    Subject to your compliance with these terms, you may use Microchip software and any 
    derivatives exclusively with Microchip products. It is your responsibility to comply with third party 
    license terms applicable to your use of third party software (including open source software) that 
    may accompany Microchip software.
    
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
    IN NO EVENT WILL MICROCHIP BE LIABLE FOR ANY INDIRECT, SPECIAL, PUNITIVE, 
    INCIDENTAL OR CONSEQUENTIAL LOSS, DAMAGE, COST OR EXPENSE OF ANY KIND 
    WHATSOEVER RELATED TO THE SOFTWARE, HOWEVER CAUSED, EVEN IF MICROCHIP 
    HAS BEEN ADVISED OF THE POSSIBILITY OR THE DAMAGES ARE FORESEEABLE. TO 
    THE FULLEST EXTENT ALLOWED BY LAW, MICROCHIP'S TOTAL LIABILITY ON ALL 
    CLAIMS IN ANY WAY RELATED TO THIS SOFTWARE WILL NOT EXCEED THE AMOUNT 
    OF FEES, IF ANY, THAT YOU HAVE PAID DIRECTLY TO MICROCHIP FOR THIS 
    SOFTWARE.
 */

#include <xc.h>
#include <string.h>
#include "mcc_generated_files/usb/usb.h"
#include "mcc_generated_files/mcc.h"
#include "usbcdc_app.h"
#include "icsp_app.h"
#include "gpio_x.h"
/*
                         Main application
 */
void main(void) {
    // initialize the device
    SYSTEM_Initialize();
    
    // Copy startup pin values from GPIO to the extended GPIO module
    gpiox_load_all_from_ports();
    // Set the pins to default function
    PORTC_x.is_PinAlternative = 0;
    PORTA_x.is_PinAlternative = 0;
    
    // When using interrupts, you need to set the Global and Peripheral Interrupt Enable bits
    // Use the following macros to:

    // Enable the Global Interrupts
    //INTERRUPT_GlobalInterruptEnable();

    // Enable the Peripheral Interrupts
    //INTERRUPT_PeripheralInterruptEnable();

    // Disable the Global Interrupts
    //INTERRUPT_GlobalInterruptDisable();

    // Disable the Peripheral Interrupts
    //INTERRUPT_PeripheralInterruptDisable();

    ICSP_MCLR_softRelease();
    while (1) {
        CLRWDT();
        USBDeviceTasks();
        USBCDC_task();
        ICSP_task();
        CDCTxService();
        if (!ICSP_active) {
            //Only interfere with GPIO if ICSP is not active.
            //During active ICSP only direct port access is supported
            gpiox_update_ports();
        }
    }
}
/**
 End of File
 */
