MicrochipTech/veryVerilog/firmware/U1_USBSerial.X/helper_funcs.h

/* 
 * File:   helper_funcs.h
 * Author: M91541
 *
 * Created on 02. Februar 2024, 13:56
 */

#ifndef HELPER_FUNCS_H
#define	HELPER_FUNCS_H

#ifdef	__cplusplus
extern "C" {
#endif


    char* u8toazpad(uint8_t num, uint8_t numDigits, char* buf);

#ifdef	__cplusplus
}
#endif

#endif	/* HELPER_FUNCS_H */
