MicrochipTech/veryVerilog/(commit log)

2024-12-17 Feat include files (#1)
    * update gitignore
    * adding files
    * enhancing readme
    * adding gh-pages
    ---------
    [assembly_steps.xlsx, miniFPGA.kicad_pcb, miniFPGA.kicad_sch]
2024-12-19 Fix u1 and u2 firmware missing (#12)
    * update firmware hex version
    * update MPLabX U1 and U2 projects
    * hide lesson image from readme
    * instruction to deploy gh-pages
    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
    [FW_comm_feature.py, FW_icsp_test.py]
2024-12-19 PCB v3 image, more details in readme (#10)
    * PCB v3 image, more details in readme
    * Update README.md
    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
2025-01-02 fix handling no EEPROM (#18)
    [icsp_hid.js]
2025-03-03 PCB v3 build instructions
2025-04-05 Add v3.0 PCB source files
2025-04-05 PCB sources for v3.0
    [miniFPGA.kicad_pcb, miniFPGA.kicad_sch]
2025-04-05 version 2 sources and gerbers
2025-04-05 PCB v3 sources gerbers and schematics for V3.0 PCB Closes #26
2025-04-05 Add readme to PCB Closes #27
2025-04-05 Add hyperlinks to relevant material Closes #30
2025-04-06 29 table misalignment (#35)
    * change default size to 850px
    * refactoring format
    [web_icsp.js]
2026-02-10 Ignoring PCB cache
2026-03-23 3D rendering corrected in DOCS (#54)
    * PCB v3 build instructions
    (cherry picked from commit 6fec380db9f3f9508b77bb5478fa1088c89183d5)
    * 3D rendering corrected in DOCS
    Fixes #37
    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
2026-03-23 DCE / DTE clarification on RX/TX (#55)
    * DCE / DTE clarification on RX/TX
    In schematics and PDF
    Fixes #41
    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
    [miniFPGA.kicad_sch]
2026-03-25 New table for programmer parameter(s). Closes #49 (#57)
    * BUGFIX: getHwBaudRate function now waits for answer
    * BUGFIX: setHwBaudRate now waits for answer and takes data from first reply chunk
    * New table for programmer parameter(s). Closes #49
    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
    [icsp_hid.js, web_icsp.js]
2026-03-25 Update web v1.8 (#56)
    * fix version v1.8
    * show message with unknown devID
    * auto close on pic programmed
    * add progress bar during operation
    * adding authors
    * added reset target
    * adding browse hex functionality
    * changing names and links of authors
    * optmized modal to ModalManager
    * extendind jquery usage
    * hidding control buttons
    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
    [icsp_hid.js, web_icsp.js]
2026-03-27 fix kicad file (#62)
    [miniFPGA.kicad_sch]
2026-03-27 prevent default behavior after closing window (#64)
    [web_icsp.js]
